Insight-Wisconsin/Airboat_Hardware/Airboat.kicad_pcb

## KiCad design Airboat.kicad_pcb (2024-11-05)

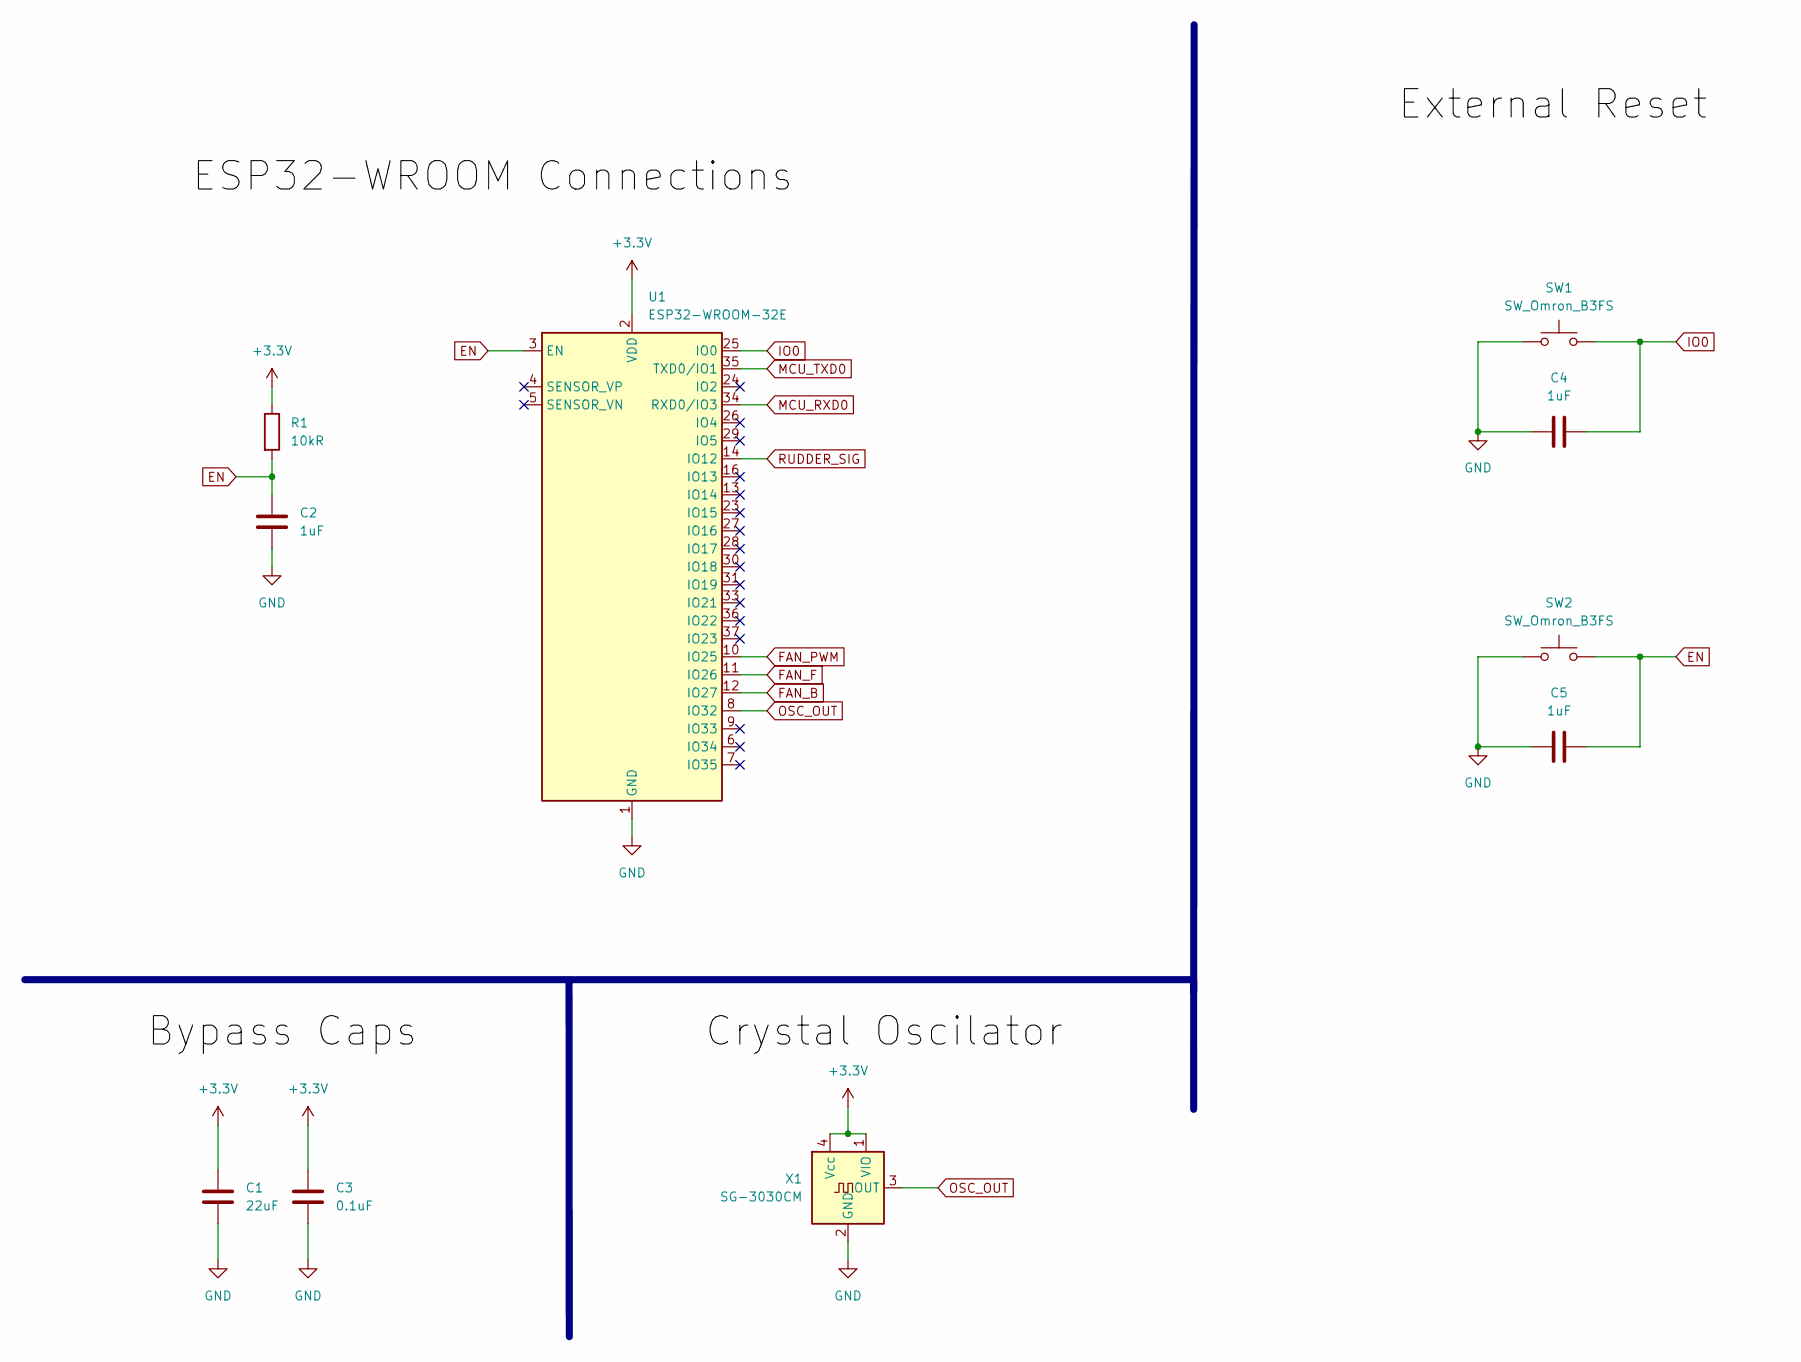
[picture p1: schematic MCU.kicad_sch]

Parts:
C1: 22uF; C_0603_1608Metric_Pad1.08x0.95mm_HandSolder
C2, C4, C5: 1uF; C_0603_1608Metric_Pad1.08x0.95mm_HandSolder
C3: 0.1uF; C_0603_1608Metric_Pad1.08x0.95mm_HandSolder
R1: 10kR; R_0603_1608Metric_Pad0.98x0.95mm_HandSolder
SW1, SW2: SW_Omron_B3FS; SW_SPST_Omron_B3FS-100xP
U1: ESP32-WROOM-32E; ESP32-WROOM-32D
X1: SG-3030CM; Oscillator_SMD_SeikoEpson_SG3030CM

Connections:
+3.3V: C1.1, C3.1, R1.1, U1.2 (VDD), X1.1 (VIO), X1.4 (Vcc); also elsewhere on the board
EN: C2.1, C5.2, R1.2, SW2.2, U1.3 (EN); also elsewhere on the board
FAN_B: U1.12 (IO27); also elsewhere on the board
FAN_F: U1.11 (IO26); also elsewhere on the board
FAN_PWM: U1.10 (IO25); also elsewhere on the board
GND: C1.2, C2.2, C3.2, C4.1, C5.1, SW1.1, SW2.1, U1.1 (GND), U1.15 (GND), U1.38 (GND), U1.39 (GND), X1.2 (GND); also elsewhere on the board
IO0: C4.2, SW1.2, U1.25 (IO0); also elsewhere on the board
MCU_RXD0: U1.34 (RXD0/IO3); also elsewhere on the board
MCU_TXD0: U1.35 (TXD0/IO1); also elsewhere on the board
OSC_OUT: U1.8 (IO32), X1.3 (OUT)
RUDDER_SIG: U1.14 (IO12); also elsewhere on the board

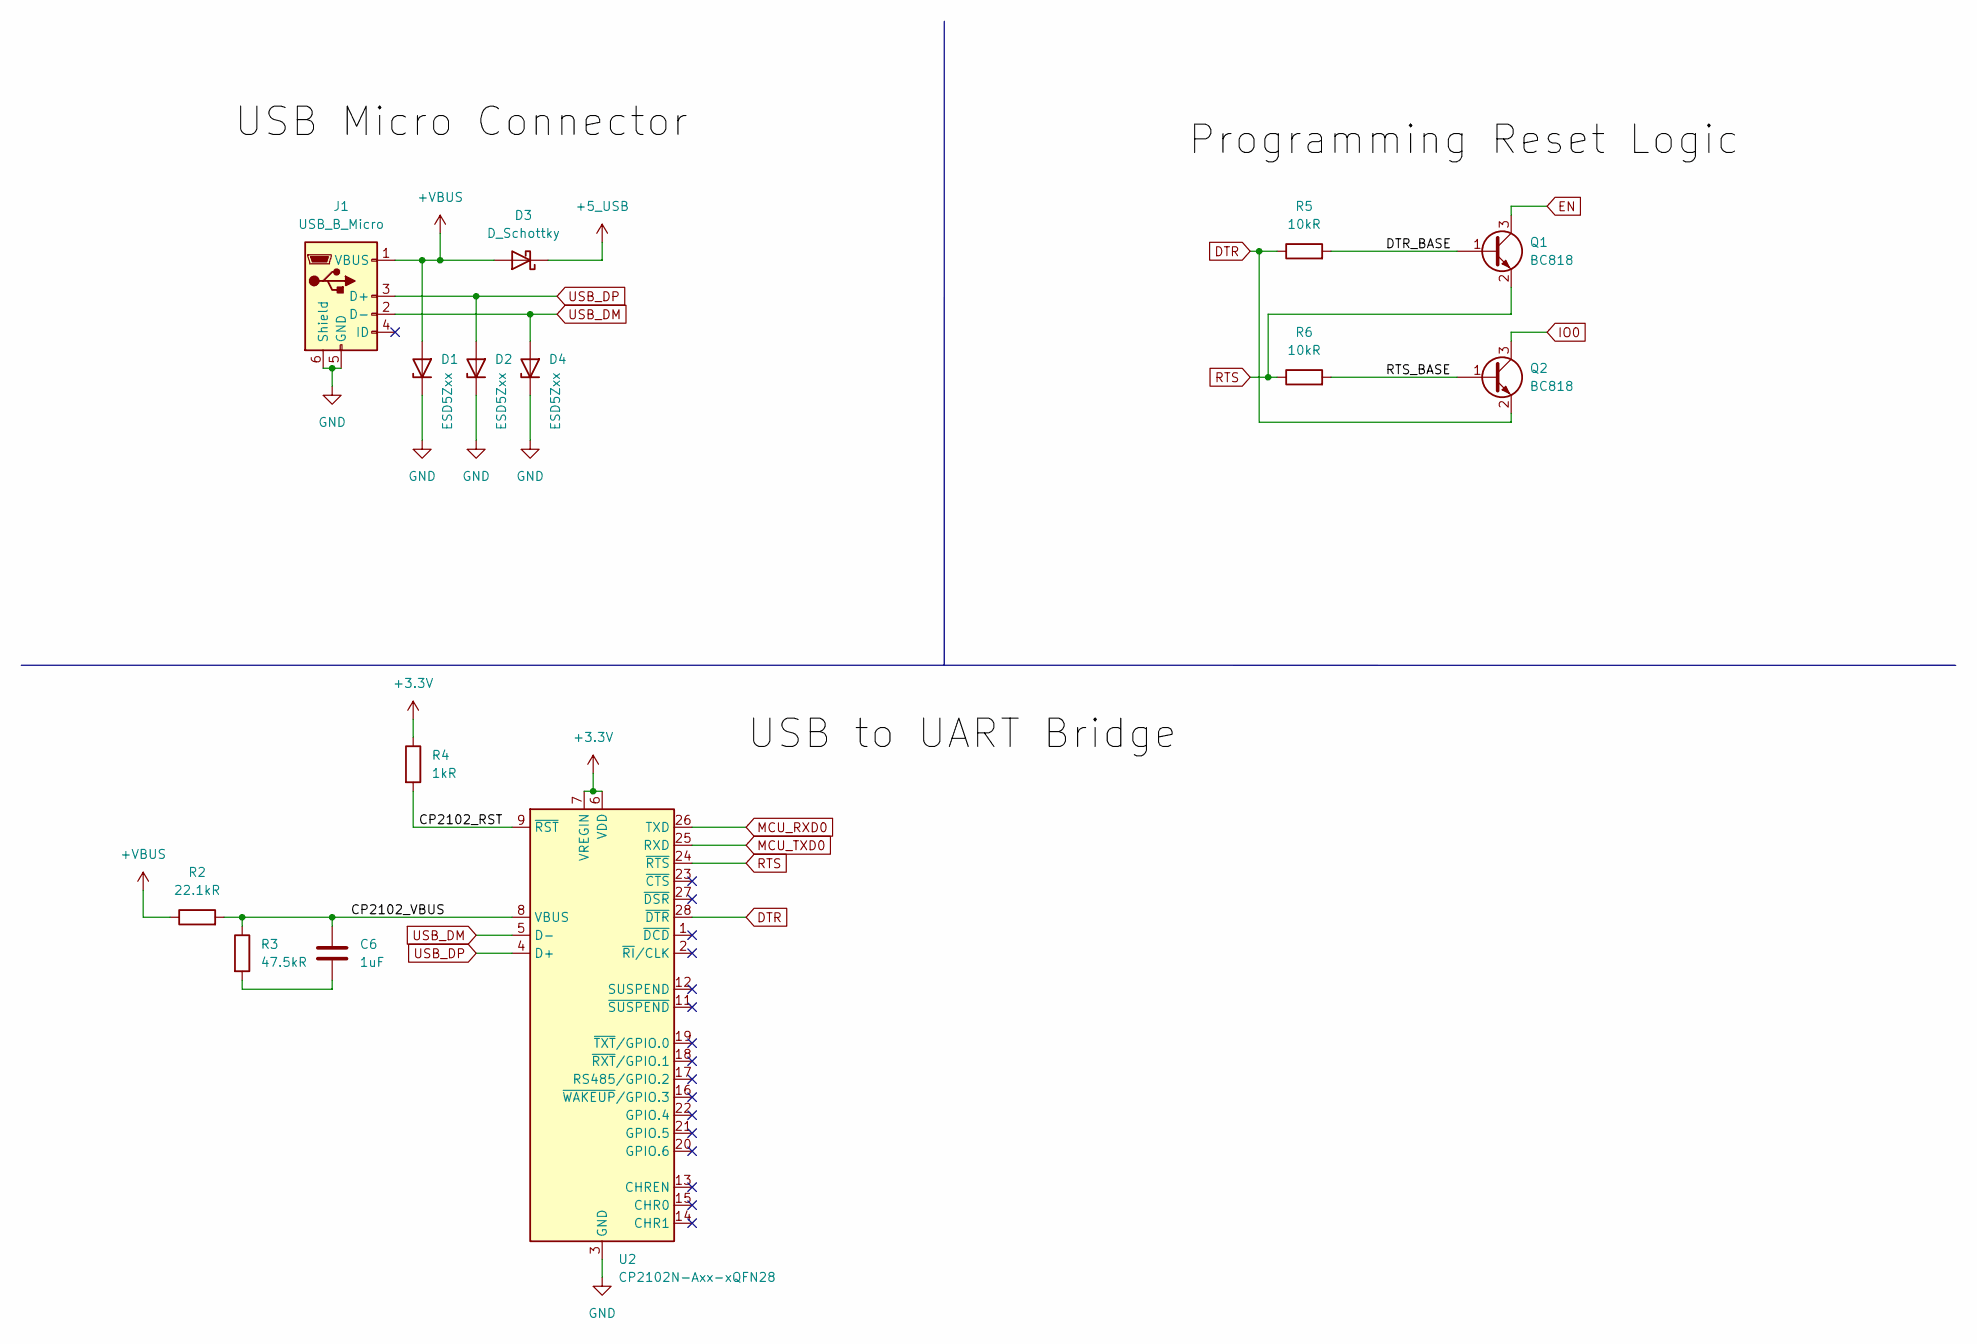
[picture p2: schematic USB.kicad_sch]

Parts:
C6: 1uF; C_0603_1608Metric_Pad1.08x0.95mm_HandSolder
D1, D2, D4: ESD5Zxx; D_SOD-523
D3: D_Schottky; D_SMC
J1: USB_B_Micro; USB_Micro-B_GCT_USB3076-30-A
Q1, Q2: BC818; SOT-23
R2: 22.1kR; R_0603_1608Metric_Pad0.98x0.95mm_HandSolder
R3: 47.5kR; R_0603_1608Metric_Pad0.98x0.95mm_HandSolder
R4: 1kR; R_0603_1608Metric_Pad0.98x0.95mm_HandSolder
R5, R6: 10kR; R_0603_1608Metric_Pad0.98x0.95mm_HandSolder
U2: CP2102N-Axx-xQFN28; QFN-28-1EP_5x5mm_P0.5mm_EP3.75x3.75mm

Connections:
+3.3V: R4.1, U2.6 (VDD), U2.7 (VREGIN); also elsewhere on the board
+5_USB: D3.1 (K); also elsewhere on the board
+VBUS: D1.2 (A), D3.2 (A), J1.1 (VBUS), R2.1
/USB/CP2102_RST: R4.2, U2.9 (~RST)
/USB/CP2102_VBUS: C6.1, R2.2, R3.1, U2.8 (VBUS)
/USB/DTR_BASE: Q1.1 (B), R5.2
/USB/RTS_BASE: Q2.1 (B), R6.2
DTR: Q2.2 (E), R5.1, U2.28 (~DTR)
EN: Q1.3 (C); also elsewhere on the board
GND: D1.1 (K), D2.1 (K), D4.1 (K), J1.5 (GND), J1.6 (Shield), U2.3 (GND), U2.29 (GND); also elsewhere on the board
IO0: Q2.3 (C); also elsewhere on the board
MCU_RXD0: U2.26 (TXD); also elsewhere on the board
MCU_TXD0: U2.25 (RXD); also elsewhere on the board
unnamed: C6.2, R3.2
RTS: Q1.2 (E), R6.1, U2.24 (~RTS)
USB_DM: D4.2 (A), J1.2 (D-), U2.5 (D-)
USB_DP: D2.2 (A), J1.3 (D+), U2.4 (D+)

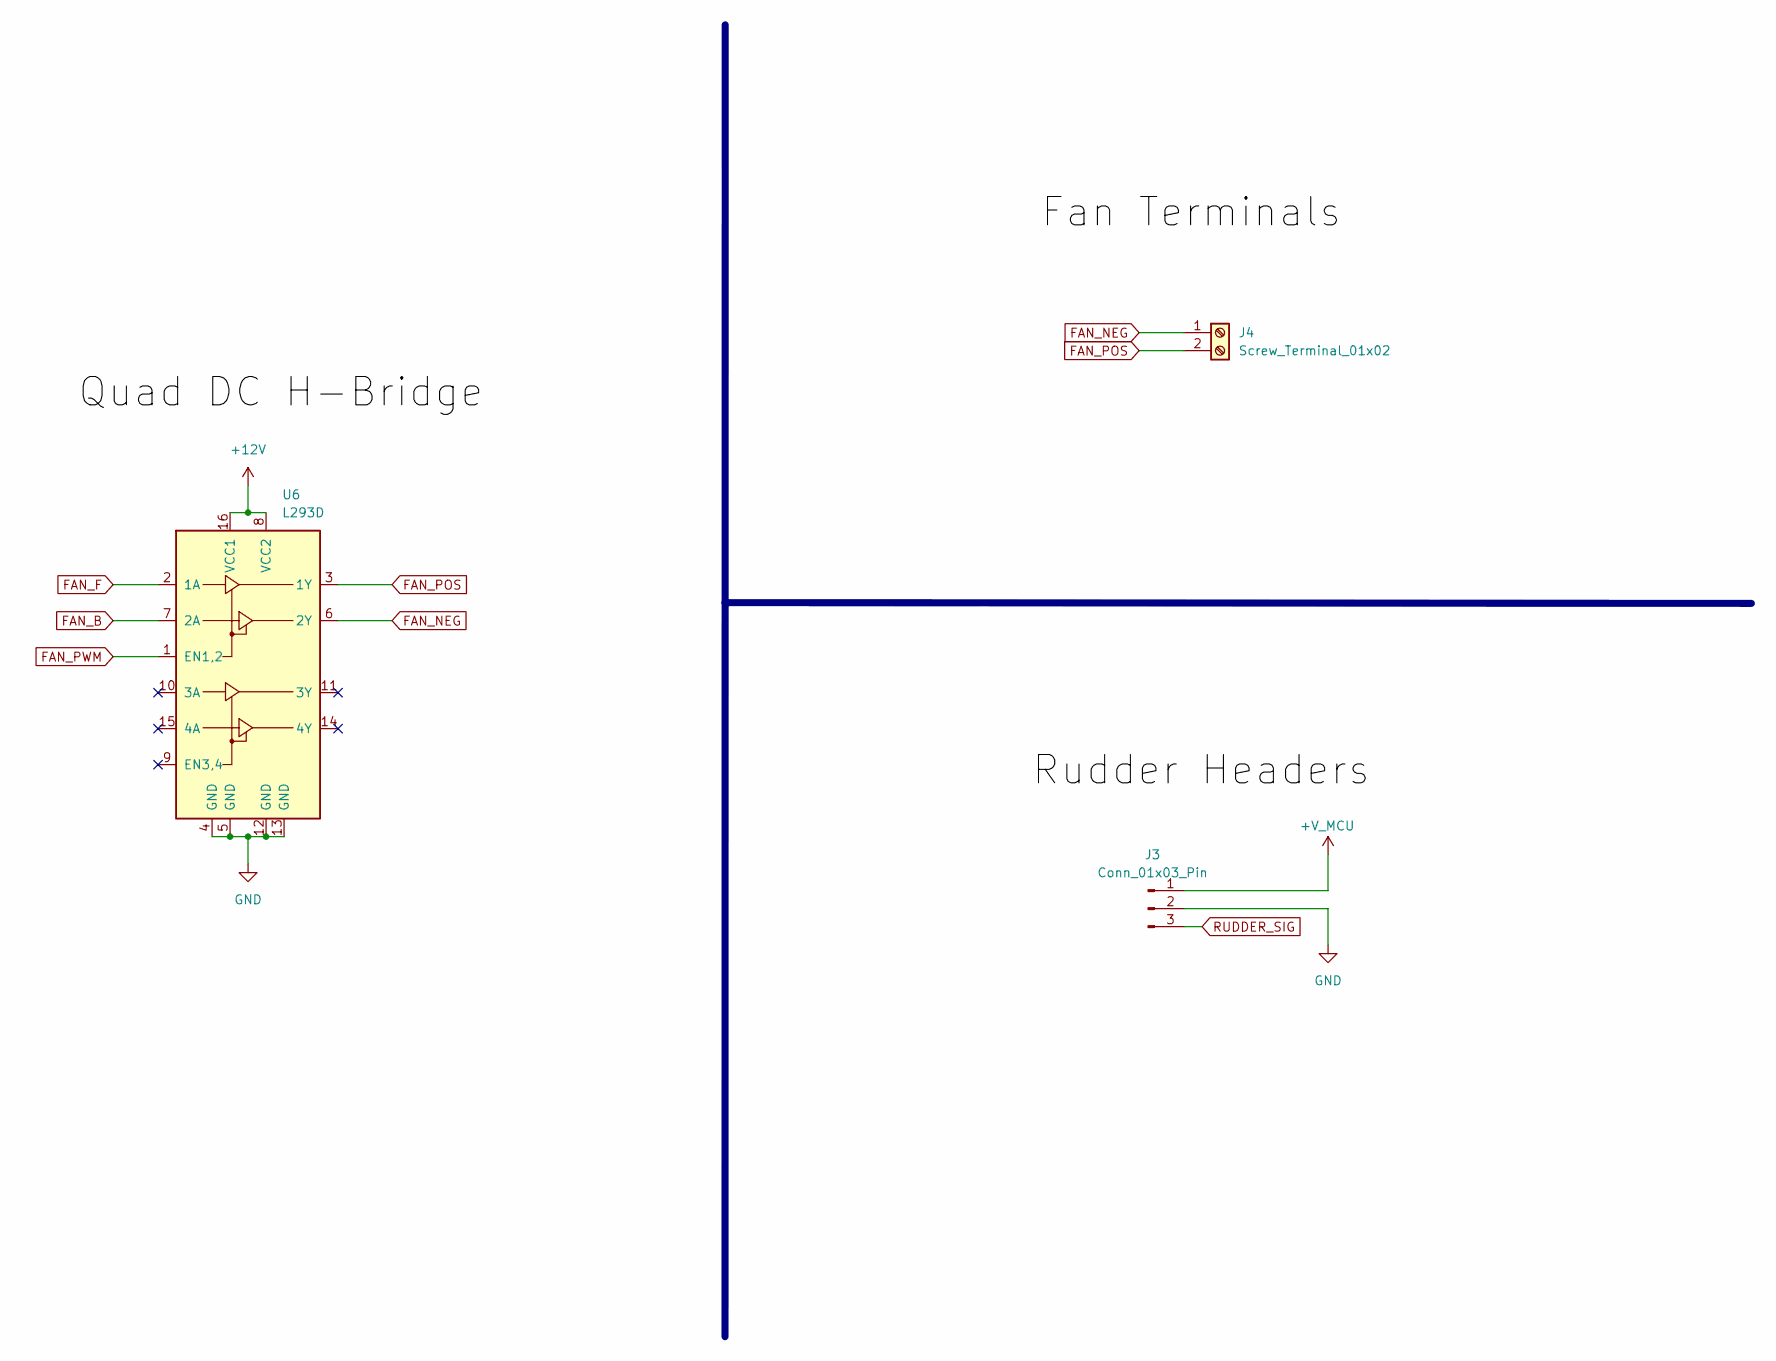
[picture p3: schematic Motor.kicad_sch]

Parts:
J3: Conn_01x03_Pin; FanPinHeader_1x03_P2.54mm_Vertical
J4: Screw_Terminal_01x02; TerminalBlock_Altech_AK300-2_P5.00mm
U6: L293D; DIP-16_W7.62mm

Connections:
+12V: U6.8 (VCC2), U6.16 (VCC1); also elsewhere on the board
+V_MCU: J3.1; also elsewhere on the board
FAN_B: U6.7 (2A); also elsewhere on the board
FAN_F: U6.2 (1A); also elsewhere on the board
FAN_NEG: J4.1, U6.6 (2Y)
FAN_POS: J4.2, U6.3 (1Y)
FAN_PWM: U6.1 (EN1,2); also elsewhere on the board
GND: J3.2, U6.4 (GND), U6.5 (GND), U6.12 (GND), U6.13 (GND); also elsewhere on the board
RUDDER_SIG: J3.3; also elsewhere on the board

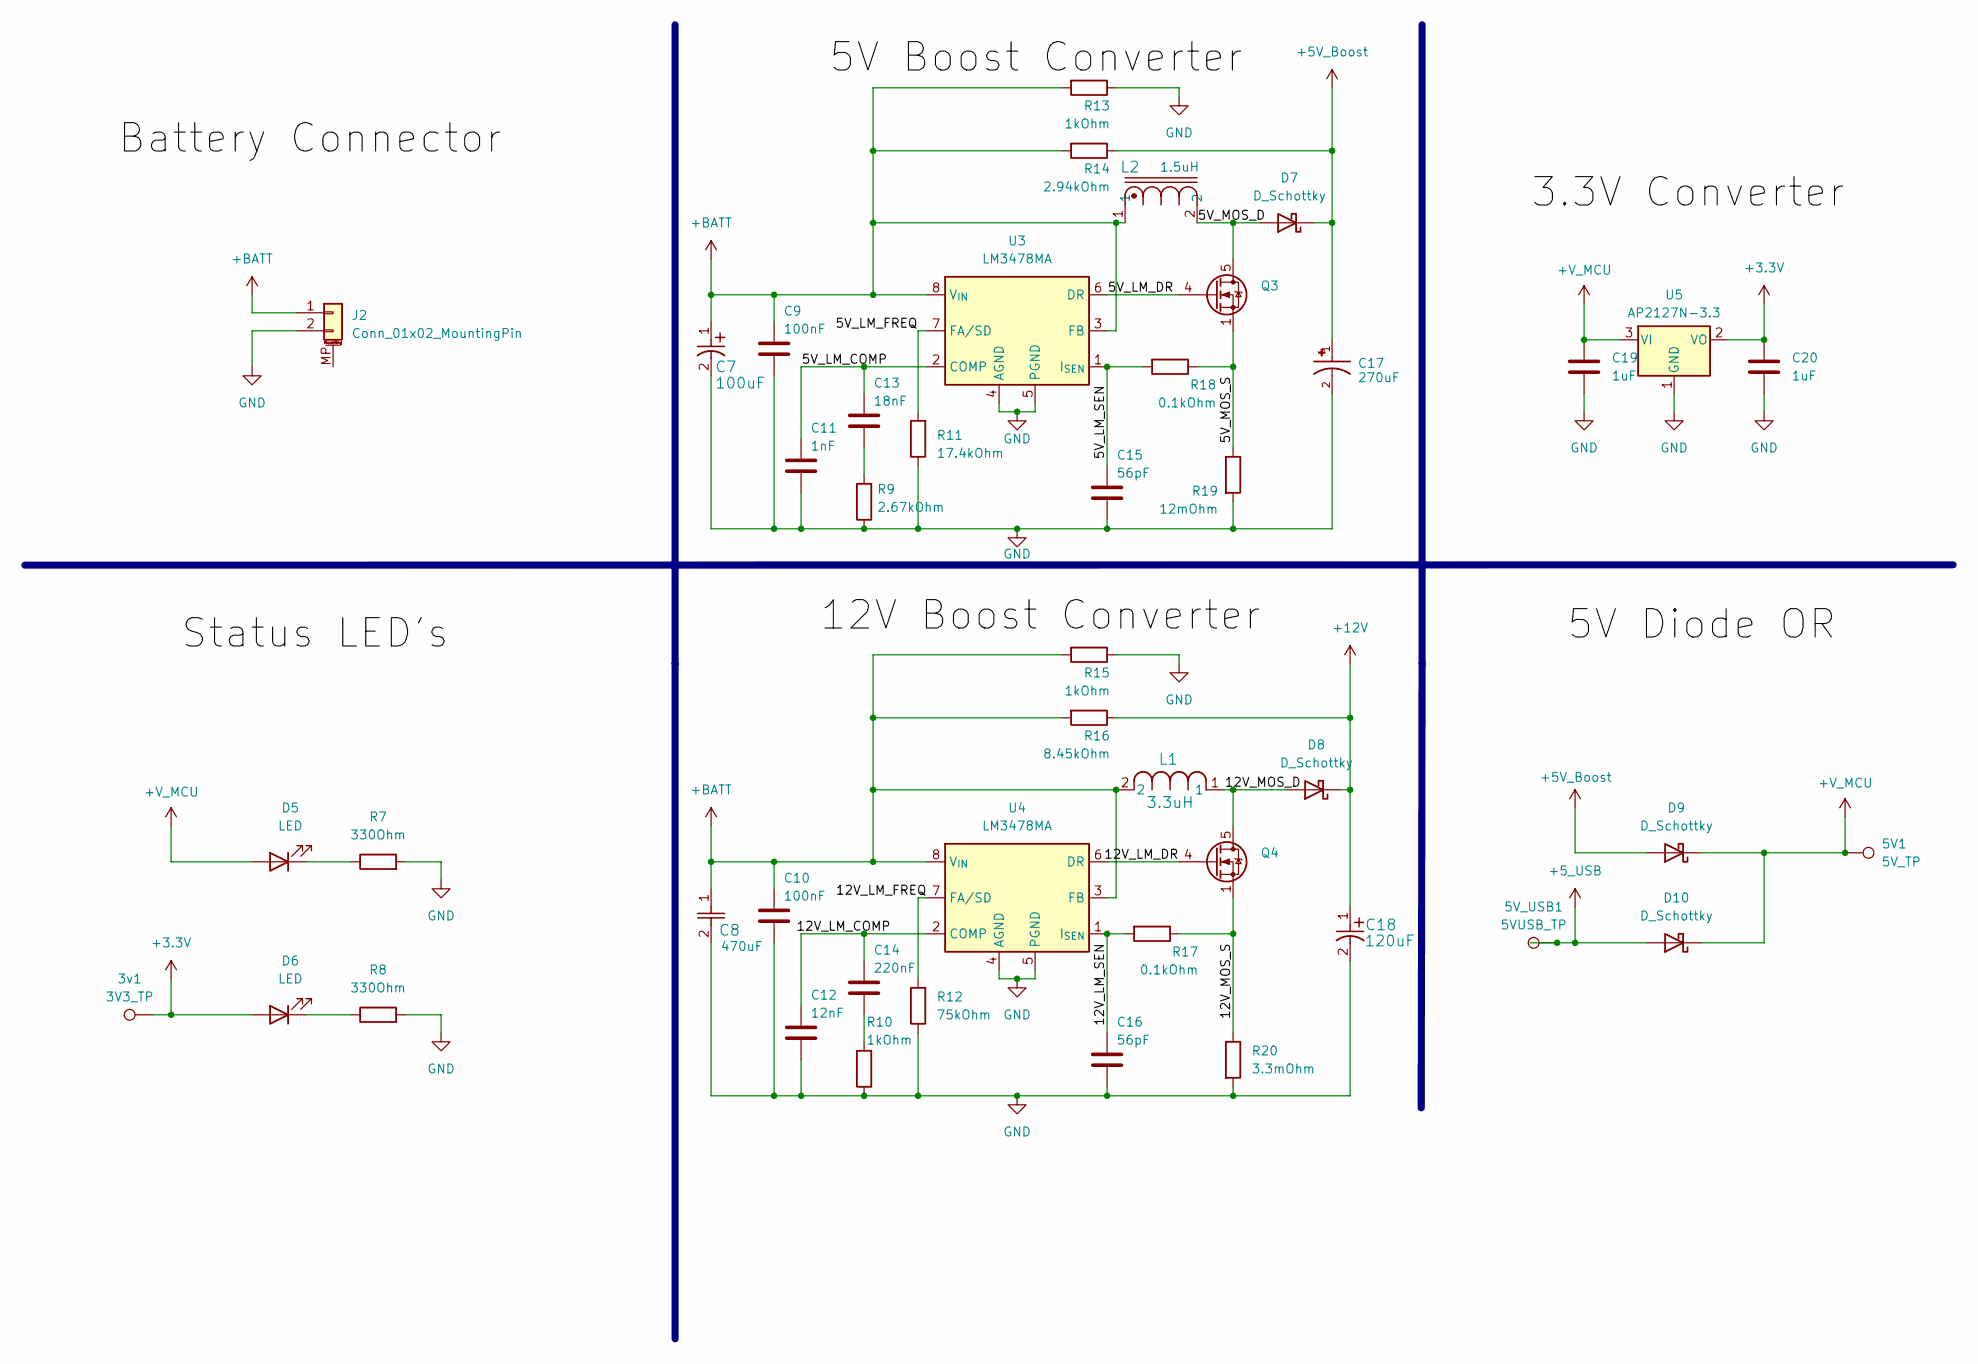
[picture p4: schematic Power.kicad_sch]

Parts:
3v1: 3V3_TP; TestPoint_Pad_D2.0mm
5V1: 5V_TP; TestPoint_Pad_D2.0mm
5V_USB1: 5VUSB_TP; TestPoint_Pad_D2.0mm
C7: T520A107M006ATE025; CAPMP3.4X1.6_1.8N_KEM
C8: UUD1E471MNL1GS; U2-R_NCH
C9, C10: 100nF; C_0603_1608Metric_Pad1.08x0.95mm_HandSolder
C11: 1nF; C_0603_1608Metric_Pad1.08x0.95mm_HandSolder
C12: 12nF; C_0603_1608Metric_Pad1.08x0.95mm_HandSolder
C13: 18nF; C_0603_1608Metric_Pad1.08x0.95mm_HandSolder
C14: 220nF; C_0603_1608Metric_Pad1.08x0.95mm_HandSolder
C15, C16: 56pF; C_0603_1608Metric_Pad1.08x0.95mm_HandSolder
C17: 16SVPG270M; CAP_16SVPG270M; PARTREV 05-Mar-21
C18: 20SVPF120M; PCAP_SVP_C6_PAN
C19, C20: 1uF; C_0603_1608Metric_Pad1.08x0.95mm_HandSolder
D5, D6: LED; LED_0805_2012Metric_Pad1.15x1.40mm_HandSolder
D7, D8, D9, D10: D_Schottky; D_SMC
J2: Conn_01x02_MountingPin; Hirose_DF3EA-02P-2H_1x02-1MP_P2.00mm_Horizontal
L1: IHLP6767GZER3R3M51; IND_IHLP-6767GZ_VIS
L2: DR1040-1R5-R; DR1040
Q3, Q4: CSD16321Q5; TDSON-8-1
R7, R8: 330Ohm; R_0603_1608Metric_Pad0.98x0.95mm_HandSolder
R9: 2.67kOhm; R_0603_1608Metric_Pad0.98x0.95mm_HandSolder
R10, R13, R15: 1kOhm; R_0603_1608Metric_Pad0.98x0.95mm_HandSolder
R11: 17.4kOhm; R_0603_1608Metric_Pad0.98x0.95mm_HandSolder
R12: 75kOhm; R_0603_1608Metric_Pad0.98x0.95mm_HandSolder
R14: 2.94kOhm; R_0603_1608Metric_Pad0.98x0.95mm_HandSolder
R16: 8.45kOhm; R_0603_1608Metric_Pad0.98x0.95mm_HandSolder
R17, R18: 0.1kOhm; R_0603_1608Metric_Pad0.98x0.95mm_HandSolder
R19: 12mOhm; R_0603_1608Metric_Pad0.98x0.95mm_HandSolder
R20: 3.3mOhm; R_2512_6332Metric_Pad1.40x3.35mm_HandSolder
U3, U4: LM3478MA; SOIC-8_3.9x4.9mm_P1.27mm
U5: AP2127N-3.3; SOT-23

Connections:
+3.3V: 3v1.1, C20.1, D6.2 (A), U5.2 (VO); also elsewhere on the board
+5V_Boost: C17.1, D7.1 (K), D9.2 (A), R14.1
+5_USB: 5V_USB1.1, D10.2 (A); also elsewhere on the board
+12V: C18.1, D8.1 (K), R16.1; also elsewhere on the board
+BATT: C7.1, C8.1, C9.1, C10.1, J2.1, L1.2, L2.1, R13.2, R14.2, R15.2, R16.2, U3.3 (FB), U3.8 (V_{IN}), U4.3 (FB), U4.8 (V_{IN})
+V_MCU: 5V1.1, C19.1, D5.2 (A), D9.1 (K), D10.1 (K), U5.3 (VI); also elsewhere on the board
/Power/5V_LM_COMP: C11.1, C13.1, U3.2 (COMP)
/Power/5V_LM_DR: Q3.4 (G), U3.6 (DR)
/Power/5V_LM_FREQ: R11.2, U3.7 (FA/SD)
/Power/5V_LM_SEN: C15.1, R18.2, U3.1 (I_{SEN})
/Power/5V_MOS_D: D7.2 (A), L2.2, Q3.5 (D)
/Power/5V_MOS_S: Q3.1 (S), Q3.2 (S), Q3.3 (S), R18.1, R19.1
/Power/12V_LM_COMP: C12.1, C14.1, U4.2 (COMP)
/Power/12V_LM_DR: Q4.4 (G), U4.6 (DR)
/Power/12V_LM_FREQ: R12.2, U4.7 (FA/SD)
/Power/12V_LM_SEN: C16.1, R17.2, U4.1 (I_{SEN})
/Power/12V_MOS_D: D8.2 (A), L1.1, Q4.5 (D)
/Power/12V_MOS_S: Q4.1 (S), Q4.2 (S), Q4.3 (S), R17.1, R20.1
GND: C7.2, C8.2, C9.2, C10.2, C11.2, C12.2, C15.2, C16.2, C17.2, C18.2, C19.2, C20.2, J2.2, R7.2, R8.2, R9.1, R10.1, R11.1, R12.1, R13.1, R15.1, R19.2, R20.2, U3.4 (AGND), U3.5 (PGND), U4.4 (AGND), U4.5 (PGND), U5.1 (GND); also elsewhere on the board
unnamed: C13.2, R9.2
unnamed: C14.2, R10.2
unnamed: D5.1 (K), R7.1
unnamed: D6.1 (K), R8.1

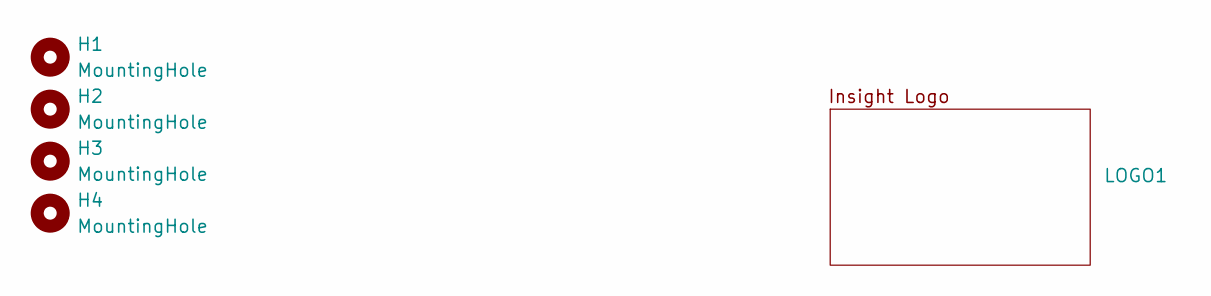
[picture p5: schematic Mechanical.kicad_sch]

Parts:
H1, H2, H3, H4: MountingHole; MountingHole_2.2mm_M2
LOGO1: Insight_Logo

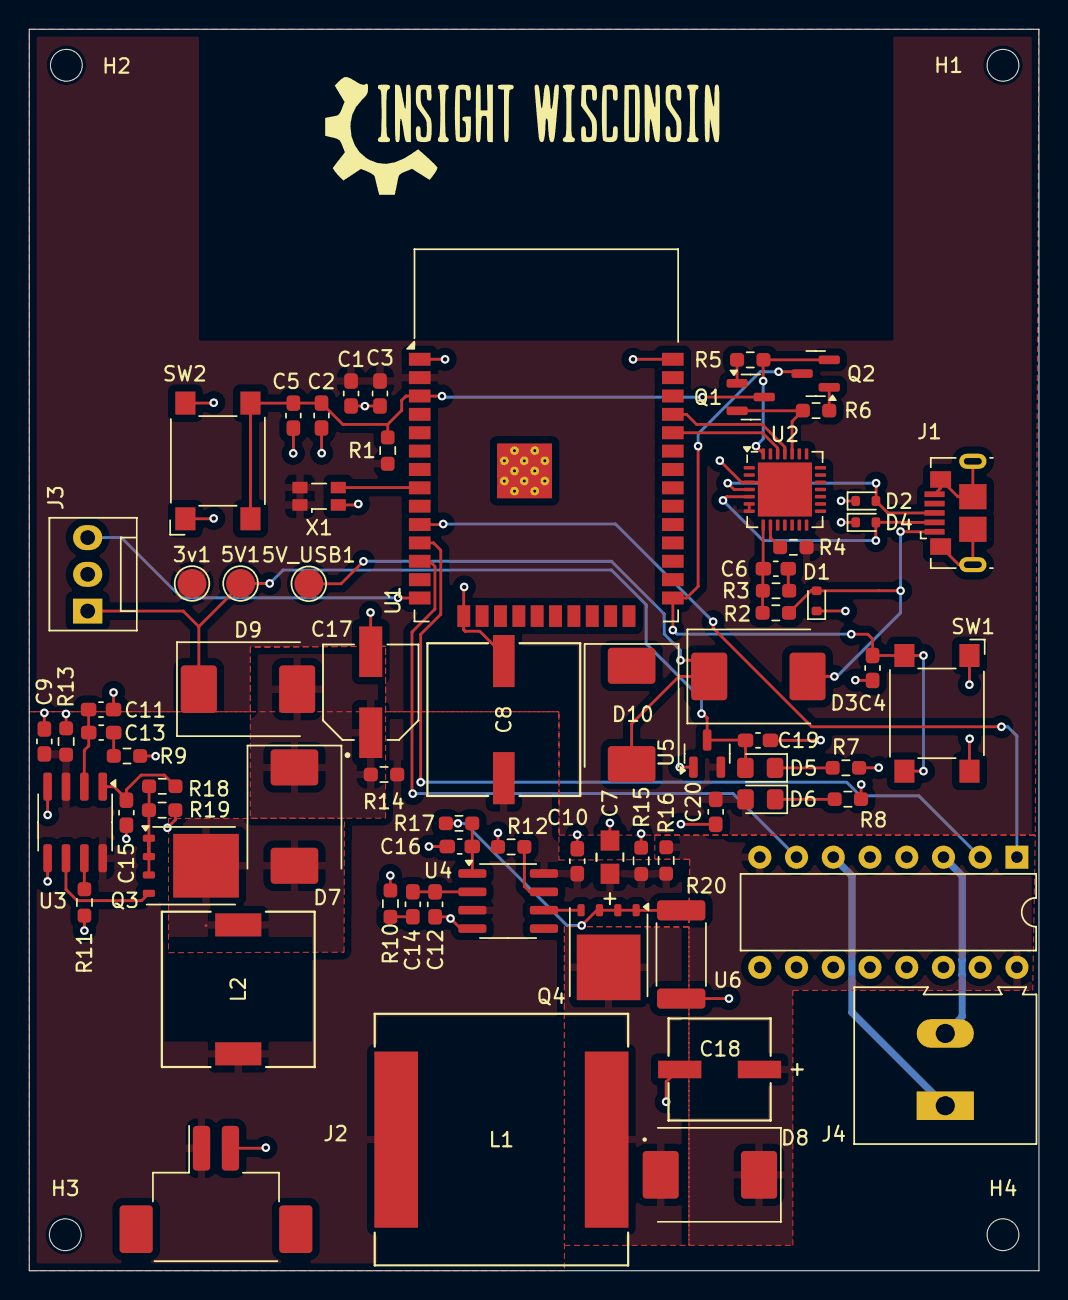
[picture p6: board Airboat.kicad_pcb from above]

Board: 2 copper layers, 69.8 x 85.9 mm, 77 parts (0 on the bottom side), 44 nets.
