Insight-Wisconsin/Airboat_Hardware/(threads)

Thread 4 (2024-11-24):

Fix D10's +V_MCU pad not touching

mmartin4064, 2024-11-24:
On D10 the copper pour does not touch the +V_MCU net so power from the USB does not reach the rest of the board. Issue can be seen below.
This will either need to be:
- Rerouted
- Reconfigured so the copper pour can make connect to the pad
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

Thread 5 (2024-11-24):

Fix USB placement

mmartin4064, 2024-11-24:
On the current revision when the board was resized the USB port did not move to the end of the board so a hole had to be cutout to insert the USB into the port. This is not ideal, so the USB port will have to be moved and the traces rerouted.

See below for issue:
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

Thread 6 (2024-11-24):

Add BATT+ test point

mmartin4064, 2024-11-24:
Currently the design does not have a testpoint for the boosted battery supply voltage it would be useful for debugging purposes to add one to the design. Examples can be found throughout the design.
Examples for +5V_USB:
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

Thread 7 (2024-11-24):

Design 5V_USB included BATT+ boosted voltage

mmartin4064, 2024-11-24:
It would be useful during the debug stage of the design to add support for boosting the 5V USB to +BATT. This would create the need to rework the topology as it has been designed to take a lithium cell as input, and not USB power.

The design rework process would be as follows:
- Spec out what the input voltage and current would be
  - Would need to find the USB power specs to determine maximum supply amperage.
  - Would also need to figure out a way to take the input cell power and match that to that of a USB
    - Probably would need to take the 5V boosted voltage. This would however woul also need to be redesigned as it currently supports 5V, 3A which is much higher power than USBPD port can provide
    - Redesign also would need to provide enough power for servo operation. Those specs can be found [here](https://www.digikey.com/en/products/detail/dfrobot/SER0006/7597224).
 - Redesign the 12V converter to still output 12V, 3A but to accept the new 5V boosted power instead of the cell voltage and amperage.

Thread 8 (2024-11-24):

The +V_MCU and GND are flipped on the servo header pins

mmartin4064, 2024-11-24:
Currently the +V_MCU and GND are flipped in both the schematic and PCB layout, to avoid rework on boards this will need to be flipped.
See below for where the changes need to take place:
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

Thread 9 (2024-11-25):

ESD Diodes are backwards

mmartin4064, 2024-11-25:
In the current design the diodes are creating a short to gnd, and in turn blowing up when plugged in. This needs to be flipped to ensure consistent functionality.
See Below:
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

Thread 10 (2024-12-21):

Both boost schematics are incorrect (i.e +5v and +12v)

mmartin4064, 2024-12-21:
The correct configuration from TI is as follows:
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
There are a couple issues between the schematic as currently laid out and the exported design from TI:
- The inductor must be moved from the resistor feedback network net to Vin
- The only thing that should be connected to the FB pin on the LM2347 should be the output from the resistor divider
- There is a missing ground connection in the +12V boost regulator

See below for pictures of the issues:
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
