Insight-Wisconsin/Airboat_Hardware/(commit log)

2024-08-12 Inital commit of kicad files
    [Airboat.kicad_pcb, Airboat.kicad_sch]
2024-08-12 Finished Updating Schematics
    [MCU.kicad_sch, Motor.kicad_sch, Power.kicad_sch, USB.kicad_sch]
2024-08-12 Fixed PCB errors
    [Airboat.kicad_pcb, Motor.kicad_sch, USB.kicad_sch]
2024-08-12 Started to layout PCB
    [Airboat.kicad_pcb, Airboat.kicad_sch, MCU.kicad_sch, Mechanical.kicad_sch, Power.kicad_sch, USB.kicad_sch]
2024-08-12 Placed all components on PCB
    [Airboat.kicad_pcb, MCU.kicad_sch, Mechanical.kicad_sch, Power.kicad_sch, USB.kicad_sch]
2024-08-13 Removed uneeeded components, started to lay PCB traces
    [Airboat.kicad_pcb, Mechanical.kicad_sch, Power.kicad_sch, USB.kicad_sch]
2024-08-13 Finished PCB routing
    [Airboat.kicad_pcb, MCU.kicad_sch, Power.kicad_sch]
2024-09-17 Updated PCB to be smaller and support stepper
    [Airboat-B_Cu.gbr, Airboat-B_Mask.gbr, Airboat-B_Paste.gbr, Airboat-B_Silkscreen.gbr, Airboat-Edge_Cuts.gbr, Airboat-F_Cu.gbr, Airboat-F_Mask.gbr, Airboat-F_Paste.gbr]
2024-11-05 Updated to use boost converters
    [Airboat.kicad_pcb, MCU.kicad_sch, Mechanical.kicad_sch, Motor.kicad_sch, Power.kicad_sch, USB.kicad_sch]
